Filip-Kin/FRC-Field-Improvements/Field Gate Handle/Field Gate Nut Retainer Thinggy.pdf

# Field Gate Handle Nut Retainer Thinggy ̶P̶a̶t̶e̶n̶t̶̶P̶e̶n̶d̶i̶n̶g̶ JK lol

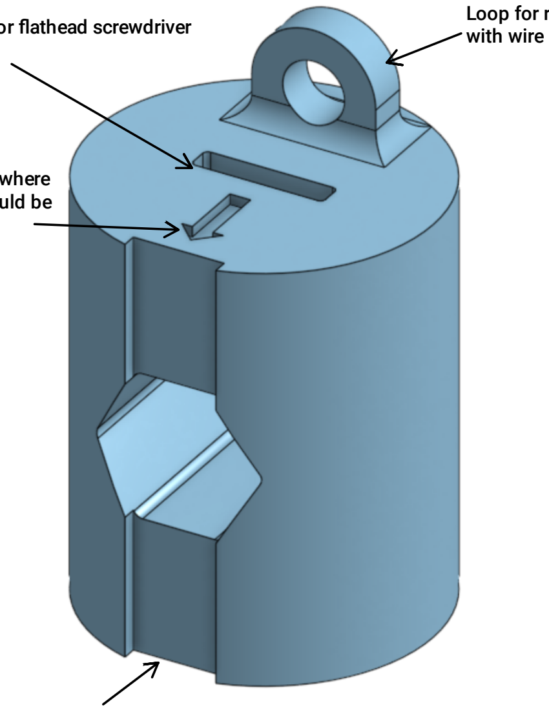
[picture p1: figure]
with wire

Slot for flathead screwdriver | Loop for removing

Arrow points to where
hole in tube should be

Recess to help clear any burrs that may remain from drilling

Recommended Print Settings:

Additional Parts & Tools:

- Threaded Stud Knob (6079K32 McMaster)
- 1/4-28 Nylock nut
- Long flat head screwdriver
- (optional) Vise grips or channel locks
- (optional) Solid wire with bend to catch loop
- (optional) Precision screwdriver or similar pointy tool Additional tools may be required to prepare
the gate for install

Orientation: as pictured
Material: PLA is acceptable Infill: 20%
Shell Thickness: 4 layers
Supports: None required

https://github.com/Filip-Kin/Field-Gate-Nut-Retainer-Thinggy

1. Remove the current knob (or bolt) from the gate. This may require a cutoff wheel, grinding, etc. Then drill out the hole in the tube that slides to 0.25".

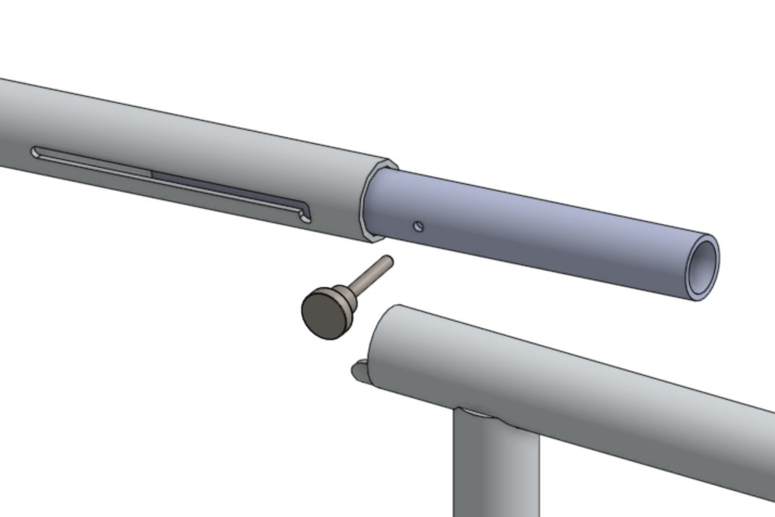
[picture p2: figure]

2. Insert a 1/4-28 nylock nut into the 3d printed part with the nylon insert facing inward.

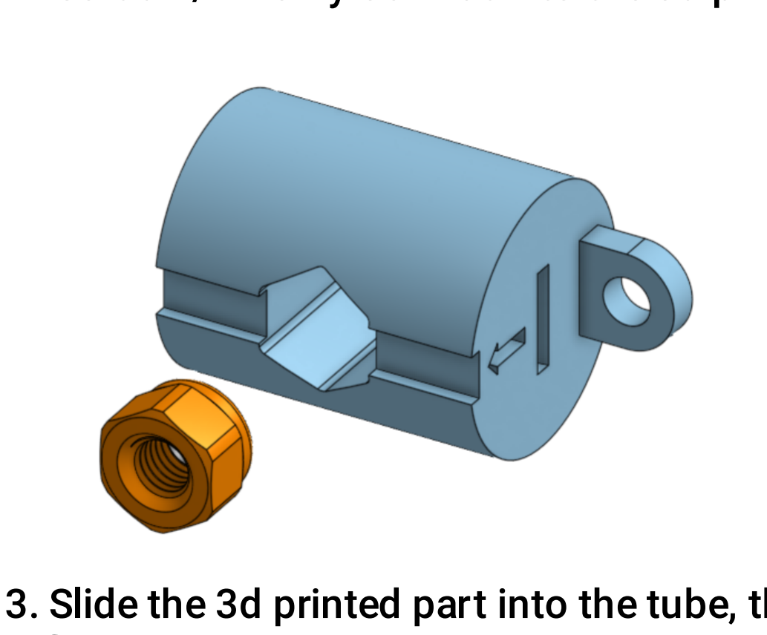
[picture p3: figure]

3. Slide the 3d printed part into the tube, the arrow should point towards the drilled hole. A flathead screwdriver can be used to help push it in and align it correctly. If you insert the assembly too far and it's stuck, you can use a wire to catch the loop and fish it out.

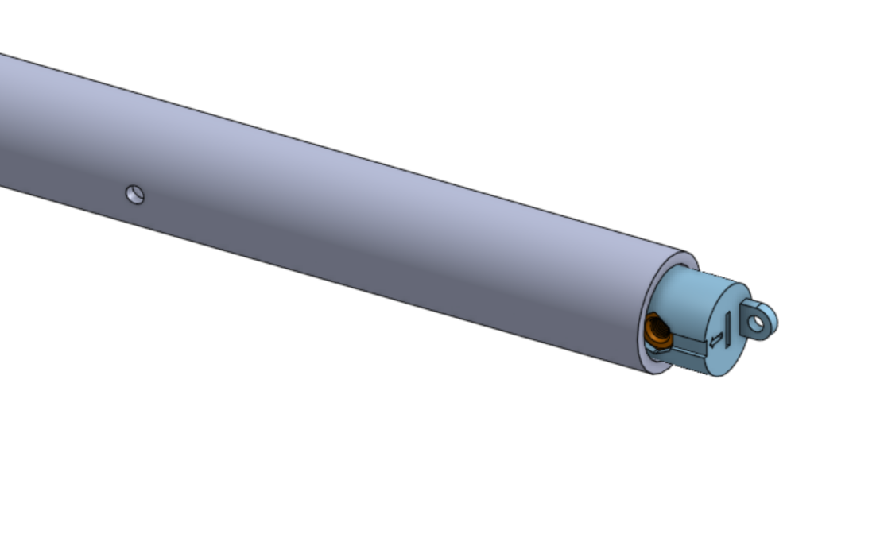
[picture p4: figure]

4. At this point you can thread the knob in partially to make sure you have everything lined up, and to hold it together until you slide it into the rest of the gate.

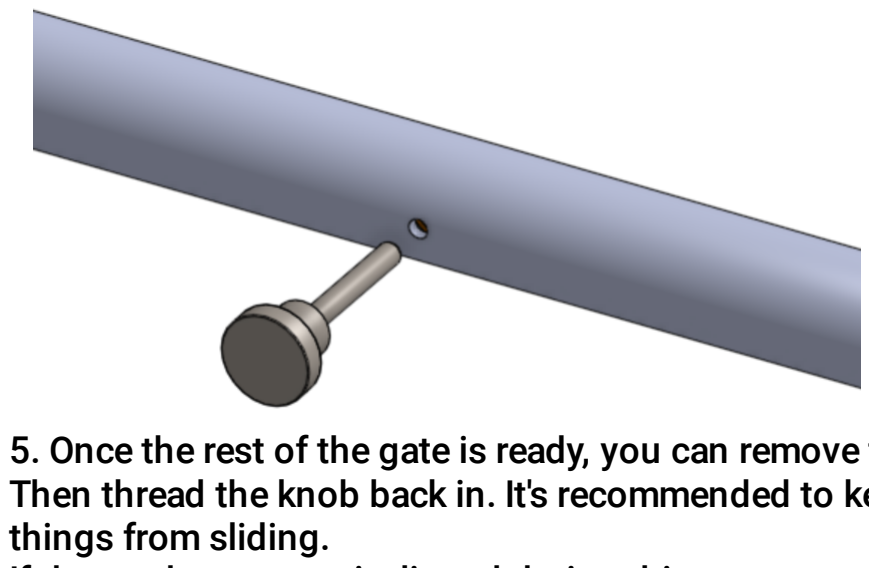
[picture p5: figure]
things from sliding.

5. Once the rest of the gate is ready, you can remove the knob and slide the inner tube into the outer. Then thread the knob back in. It's recommended to keep the gate as close to level as possible to keep

If the nut becomes misaligned during this process, you may be able to use a small screwdriver through the 0.25" hole to save the situation.

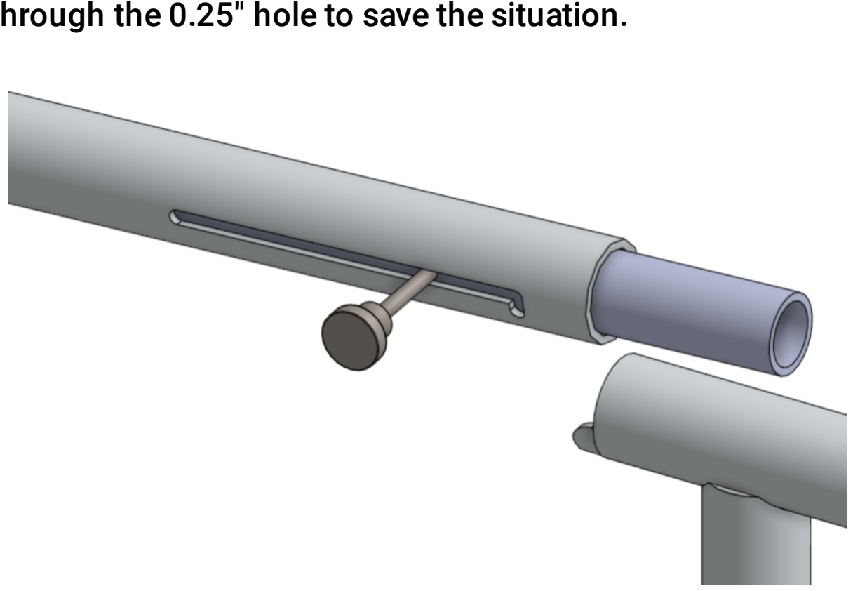
[picture p6: figure]

6. Tighten the knob until the thread hits the inside wall of the tube. If tightening by hand you
will feel more resistance at that point, and if using the specified knobs there will be a little less than 7/16" of thread remaining between the outside tube and bottom of the knob.

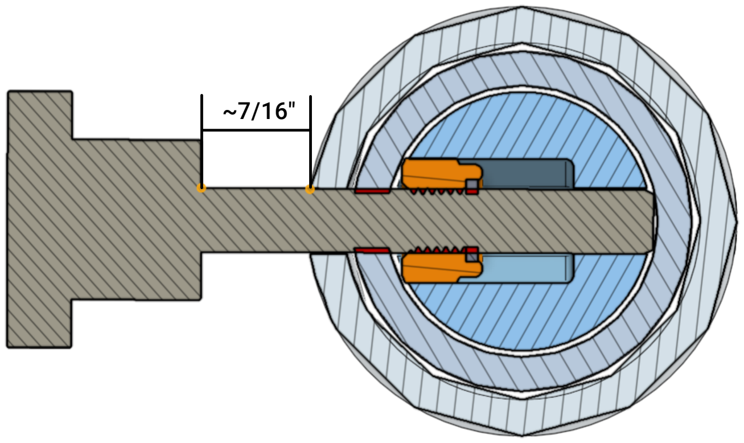
[picture p7: figure]
