Filip-Kin/FRC-Field-Improvements/Ethernet Dongle Holder/Mount.STEP

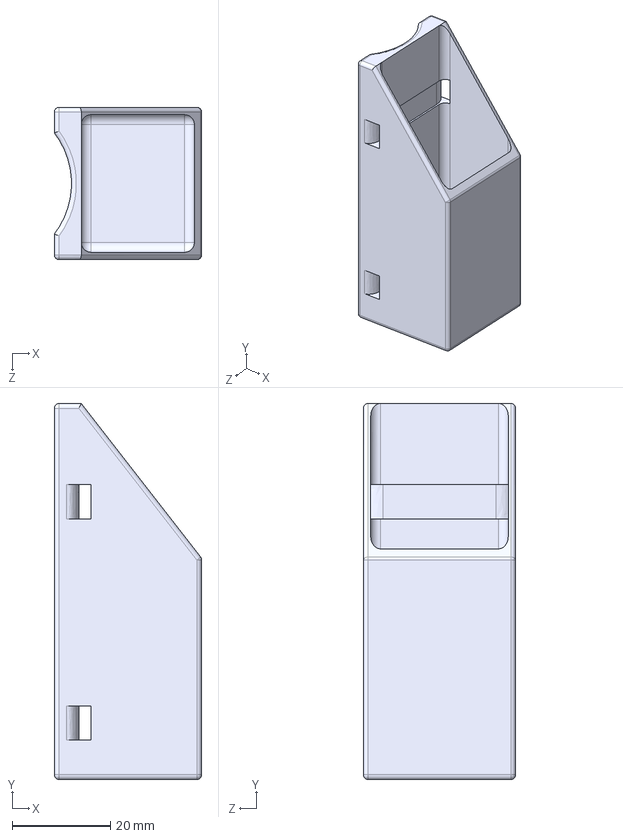
[picture p8: CAD file, 2024-08-26]
Ethernet Dongle Holder/Mount.STEP
30.0 x 76.5 x 31.0 mm
