Filip-Kin/FRC-Field-Improvements/Field Gate Handle/Field Gate Handle Nut Retainer Thinggy.step

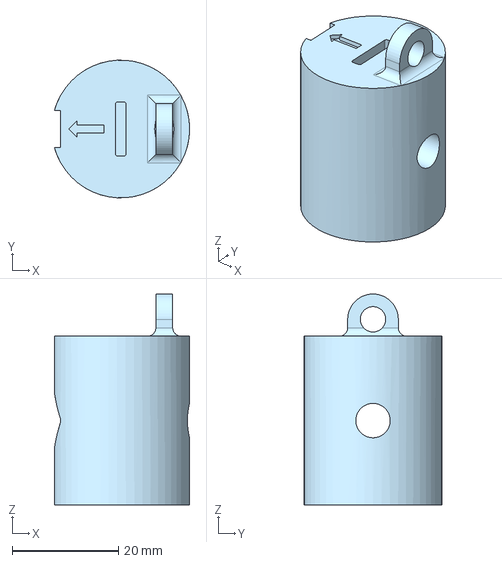
[picture p9: CAD file, 2024-02-12]
Field Gate Handle/Field Gate Handle Nut Retainer Thinggy.step
25.4 x 25.9 x 39.7 mm
