Filip-Kin/FRC-Field-Improvements/(list of files, cad)

Other CAD files:
Ethernet Dongle Holder/Mount V5.3MF
Ethernet Dongle Holder/Mount.SLDPRT
Field Gate Handle/Field Gate Handle Nut Retainer Thinggy.stl
